marcin-chwedczuk/vga-experiments/schematics/vga-arduino.pdf

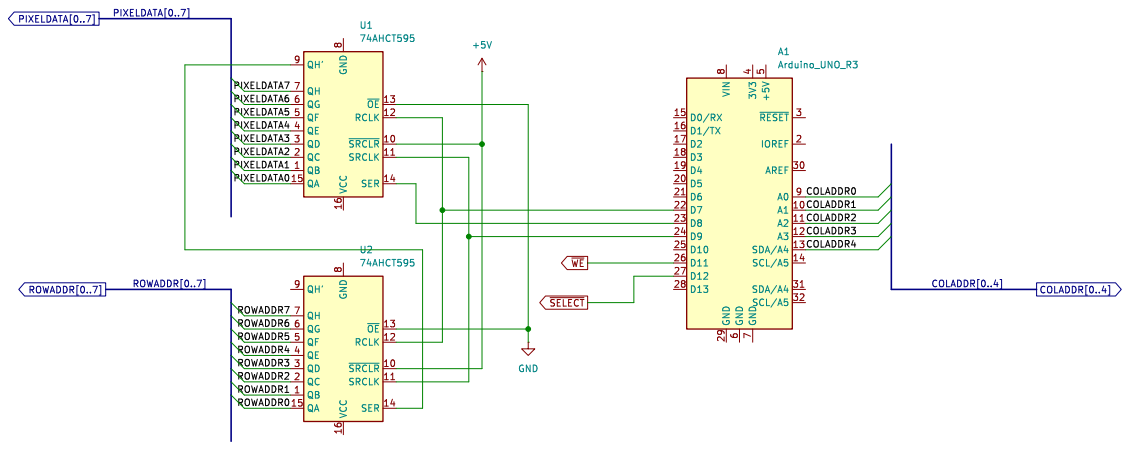
[picture p5: page 1]

8 A0 9 A1Arduino_UNO_R3 GND QB 1 ~{SRCLR} 10 SRCLK 11 RCLK 12 ~{OE} 13 SER 14 QA 15 VCC 16 QC 2 QD 3 QE 4 QF 5 QG 6 QH 7 GND

Id: 1/1 Title: File: vga-arduino.kicad_sch Sheet: /
