marcin-chwedczuk/vga-experiments/schematics/vga-memory.pdf

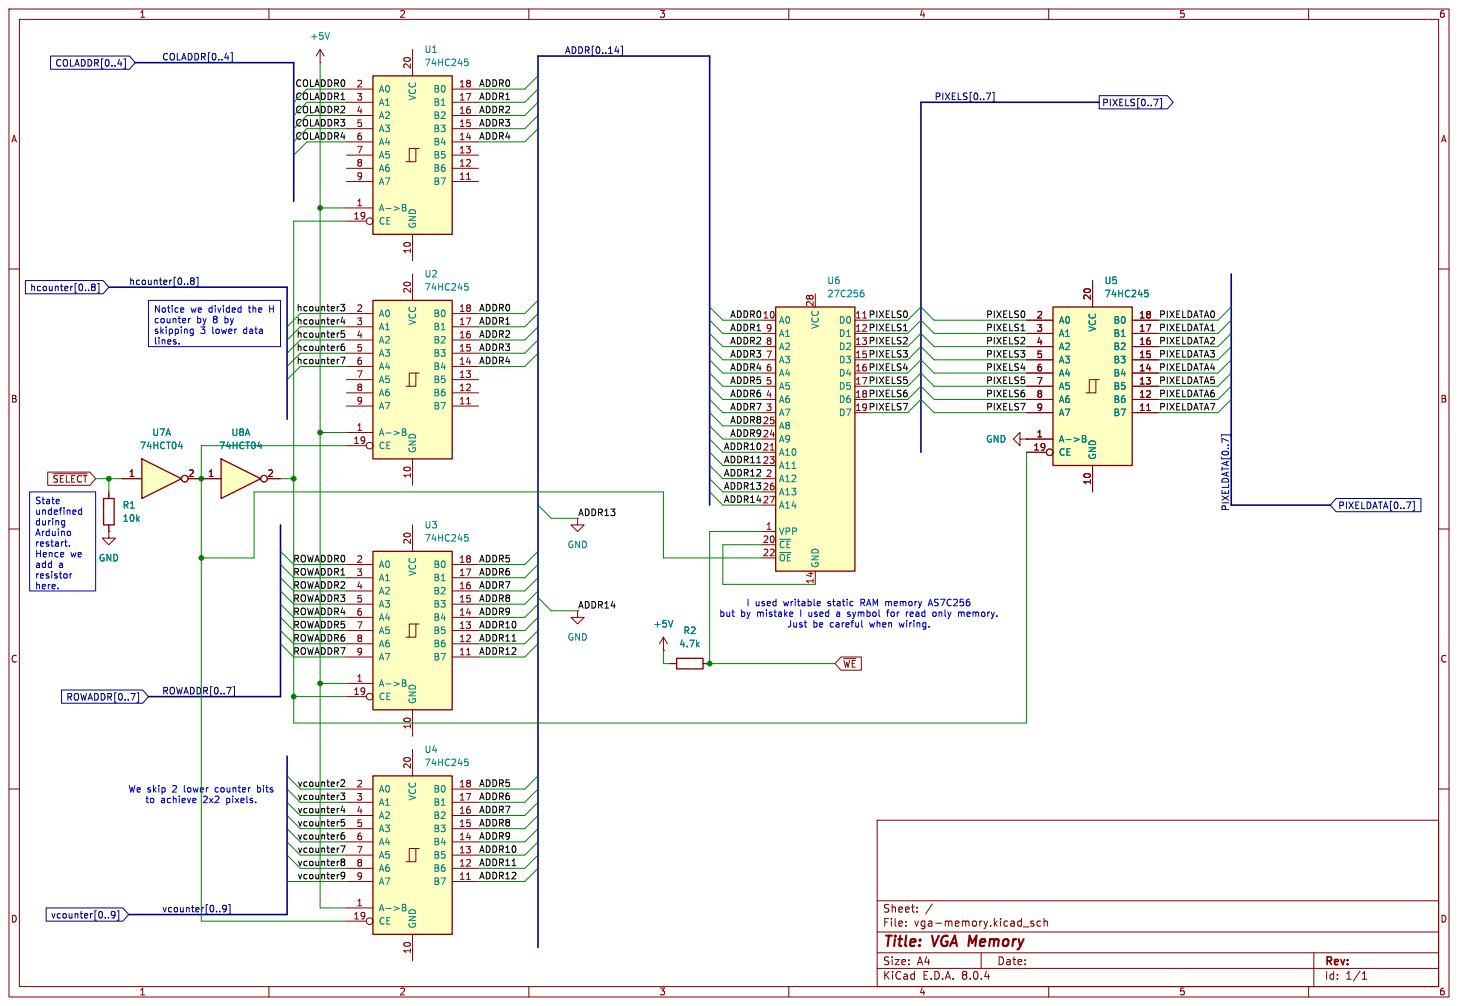
[picture p6: page 1]

Notice we divided the H
counter by 8 by

File: vga-memory.kicad_sch Sheet: /
Id: 1/1 Title: VGA Memory
