marcin-chwedczuk/vga-experiments/schematics/vga-timings.pdf

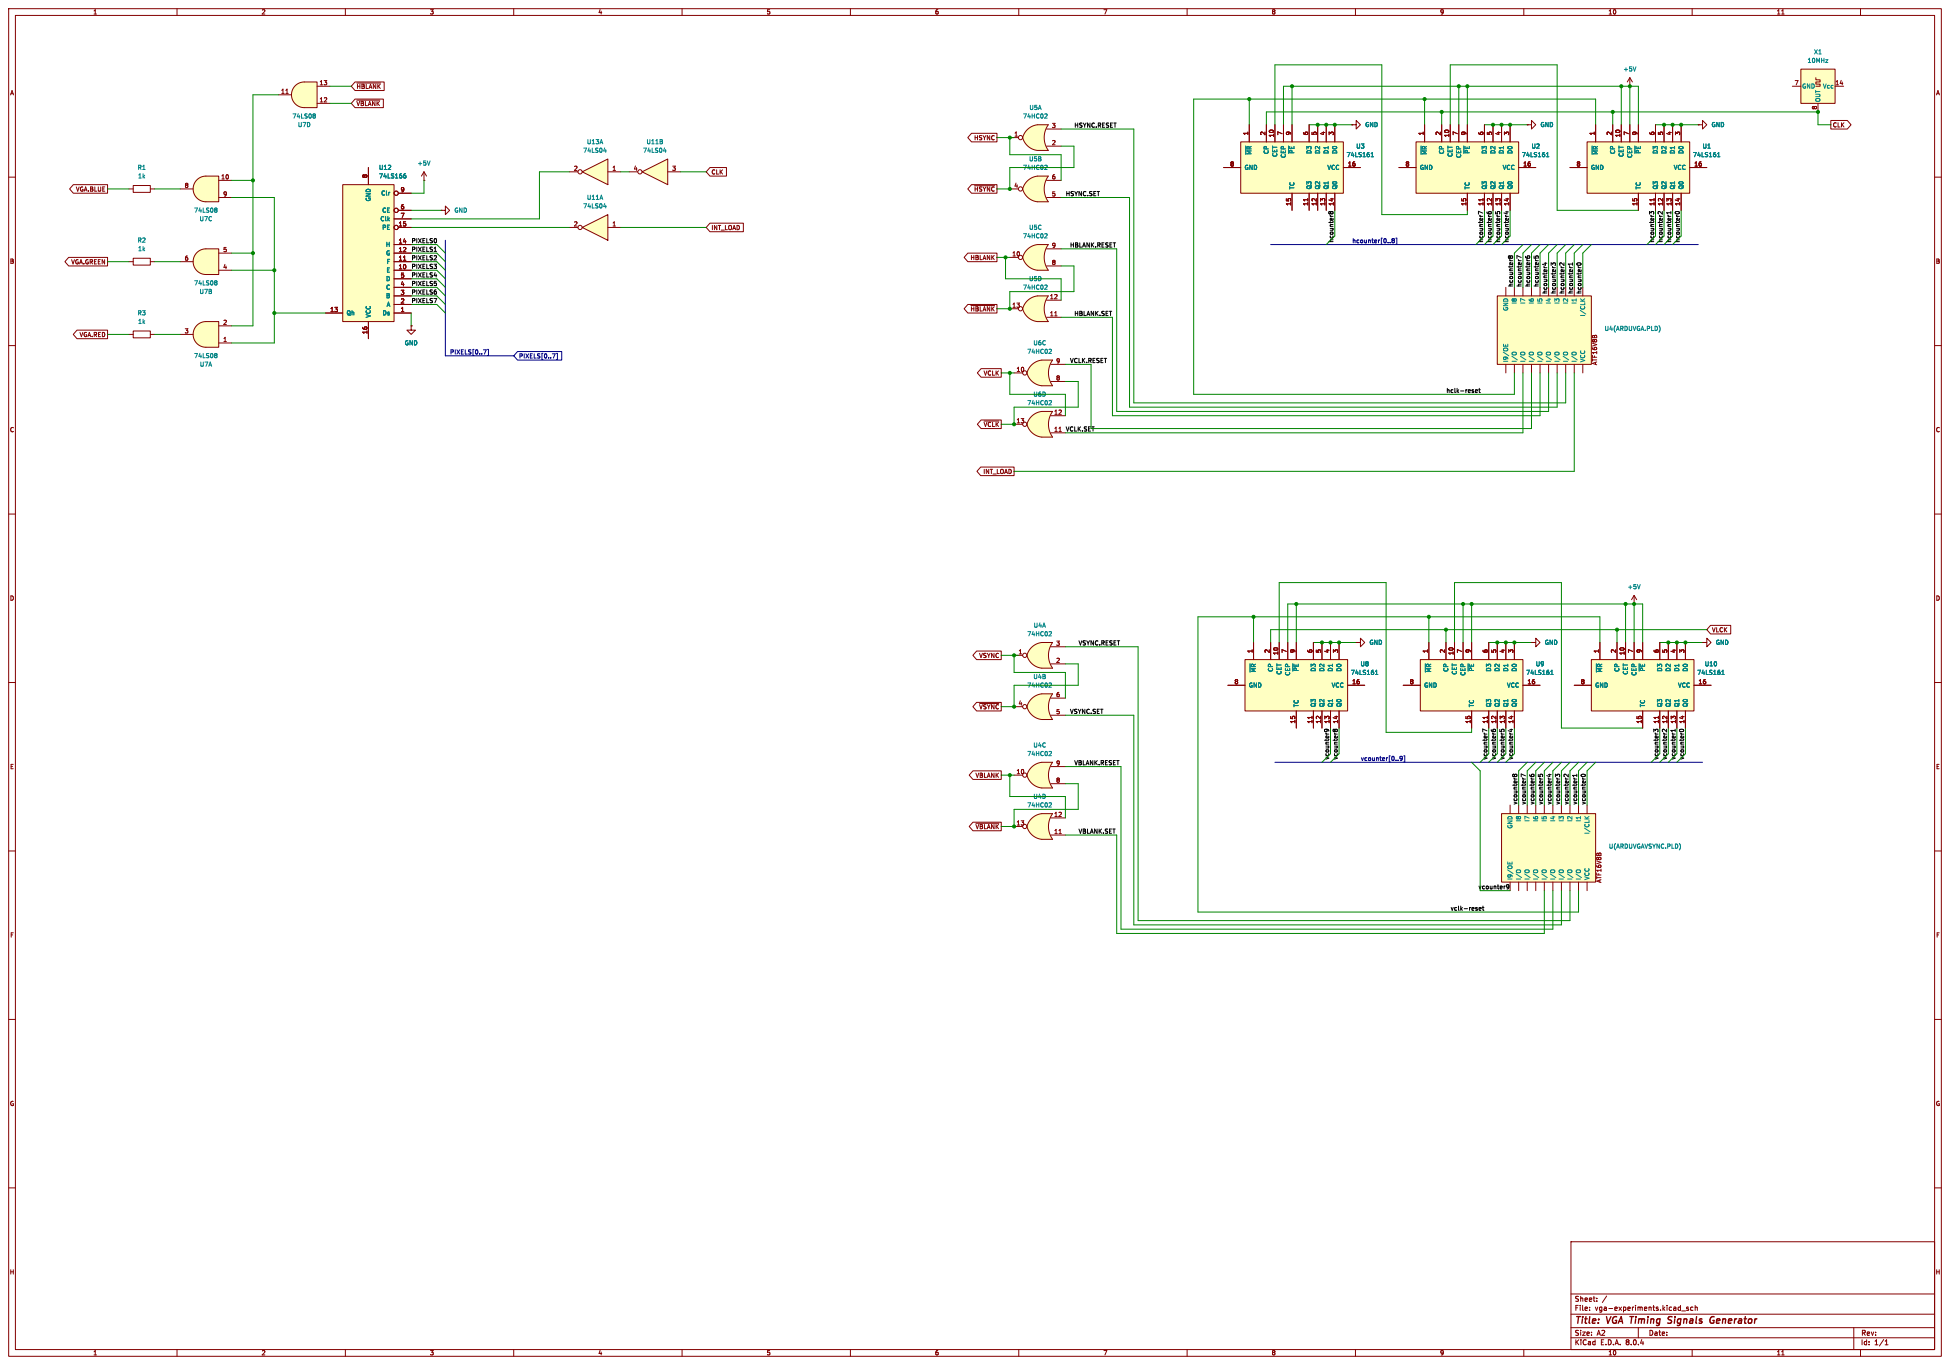
[picture p7: page 1]
