marcin-chwedczuk/vga-experiments/arduino-pictures-demo/vga-experiments-pictures.ino

// Images taken from: https://www.reddit.com/r/PixelArt/comments/jydset/another_compilation_of_1bit_pixel_art_pieces_took/

#define IMAGE_WIDTH (200)
#define IMAGE_HEIGHT (150)
static const uint8_t PROGMEM image_balloon[] = {
    0b11111110, 0b00000000, 0b00000000, 0b00000000, 0b00000000, 0b00000000, 0b00000000, 0b00000000, 0b00000000, 0b00000000, 0b00000000, 0b00000000, 0b00000000, 0b00000000, 0b00000000, 0b00000000, 0b00000000, 0b00000000, 0b00000000, 0b00000000, 0b00000000, 0b00000000, 0b00000000, 0b00000000, 0b00011111,
    0b11111100, 0b00000000, 0b00000000, 0b00000000, 0b00000000, 0b00000000, 0b00000000, 0b00000000, 0b00000000, 0b00000000, 0b00000000, 0b00000000, 0b00000000, 0b00000000, 0b00000000, 0b00000000, 0b00000000, 0b00000000, 0b00000000, 0b00000000, 0b00000000, 0b00000000, 0b00000000, 0b00000000, 0b00011111,
    0b11111110, 0b00000000, 0b00000000, 0b00000000, 0b00000000, 0b00000000, 0b00000000, 0b00000000, 0b00000000, 0b00000000, 0b00000000, 0b00000000, 0b00000000, 0b00000000, 0b00000000, 0b00000000, 0b00000000, 0b00000000, 0b00000000, 0b00000000, 0b00000000, 0b00000000, 0b00000000, 0b00000000, 0b00011111,
    0b11111100, 0b00000000, 0b00000000, 0b00000000, 0b00000000, 0b00000000, 0b00000000, 0b00000000, 0b00000000, 0b00000000, 0b00000000, 0b00010000, 0b00000001, 0b00010000, 0b00000000, 0b00000000, 0b00000000, 0b00000000, 0b00000000, 0b00000000, 0b00000000, 0b00000000, 0b00000000, 0b00000000, 0b00011111,
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
    0b00000000, 0b00000000, 0b00000000, 0b00000000, 0b00000000, 0b00000000, 0b00000110, 0b00000000, 0b01111001, 0b00100100, 0b10001001, 0b00100100, 0b10010010, 0b01000101, 0b01000101, 0b00000001, 0b11101111, 0b01111111, 0b11111110, 0b00000000, 0b00000000, 0b00000000, 0b00000000, 0b00000000, 0b01100110,
    0b00000000, 0b00000000, 0b00000000, 0b00000000, 0b00000000, 0b00000000, 0b00000110, 0b00000000, 0b01111000, 0b00000000, 0b00000000, 0b00000000, 0b00000000, 0b00000000, 0b00000000, 0b00000001, 0b11111111, 0b11111111, 0b10111110, 0b00000000, 0b00000000, 0b00000000, 0b00000000, 0b00000000, 0b01100110,
    0b00010000, 0b00000000, 0b00000000, 0b00000000, 0b00000000, 0b00000000, 0b00001010, 0b00000010, 0b10001001, 0b01010101, 0b01010101, 0b01010101, 0b01010101, 0b01011010, 0b10110101, 0b01110001, 0b00011101, 0b11111101, 0b11110010, 0b00000000, 0b00000000, 0b00000000, 0b00000000, 0b00000000, 0b10100110,
    0b00011000, 0b00000000, 0b00000000, 0b00000000, 0b00000000, 0b00000000, 0b00011000, 0b00000111, 0b10000001, 0b11111111, 0b11111111, 0b11111111, 0b11111111, 0b11111111, 0b11111111, 0b11111000, 0b00011111, 0b11110111, 0b11111000, 0b00000000, 0b00000000, 0b00000000, 0b00000000, 0b00000001, 0b10000110,
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
};

#define PIN_VGA_MODE_SELECTOR 12
#define VGA_MODE_READ LOW
#define VGA_MODE_WRITE HIGH

#define PIN_MEM_WRITE 11

#define PIN_SHIFT_REG_LATCH 7
#define PIN_SHIFT_REG_DATA 8
#define PIN_SHIFT_REG_CLK 9

void setColumnAddr(uint8_t addr) {
  // Column address A0 - A4
  int apins[] = { A0, A1, A2, A3, A4 };
  for (int i = 0; i < sizeof(apins) / sizeof(apins[0]); i++) {
    digitalWrite(apins[i], (addr & 1) ? HIGH : LOW);
    addr >>= 1;
  }
}

void setRowAddrAndData(uint8_t rowAddr, uint8_t data) {
  digitalWrite(PIN_SHIFT_REG_LATCH, LOW);

  shiftOut(PIN_SHIFT_REG_DATA, PIN_SHIFT_REG_CLK, MSBFIRST, rowAddr);
  shiftOut(PIN_SHIFT_REG_DATA, PIN_SHIFT_REG_CLK, MSBFIRST, data);

  digitalWrite(PIN_SHIFT_REG_LATCH, HIGH);
}

void setup() {
  pinMode(PIN_MEM_WRITE, OUTPUT);  
  digitalWrite(PIN_MEM_WRITE, HIGH);

  pinMode(PIN_VGA_MODE_SELECTOR, OUTPUT);
  digitalWrite(PIN_VGA_MODE_SELECTOR, VGA_MODE_READ);

  pinMode(PIN_SHIFT_REG_LATCH, OUTPUT);
  pinMode(PIN_SHIFT_REG_DATA, OUTPUT);
  pinMode(PIN_SHIFT_REG_CLK, OUTPUT);

  // Column address A0 - A4
  int apins[] = { A0, A1, A2, A3, A4 };
  for (int i = 0; i < sizeof(apins) / sizeof(apins[0]); i++) {
    pinMode(apins[i], OUTPUT);
    digitalWrite(apins[i], LOW);
  }
}

void write(int row, int col, uint8_t data) {
  setColumnAddr(col);
  setRowAddrAndData((uint8_t)row, data);

  digitalWrite(PIN_VGA_MODE_SELECTOR, VGA_MODE_WRITE);
  delay(0);
  // Generate write pulse

  digitalWrite(PIN_MEM_WRITE, LOW);
  delay(0);
  digitalWrite(PIN_MEM_WRITE, HIGH);

  delay(0);
  digitalWrite(PIN_VGA_MODE_SELECTOR, VGA_MODE_READ);
}

void displayImage(const uint8_t img[]) {
  for (int row = 0; row < 200; row++) {
    for (int col = 0; col < 25; col++) {
      uint8_t data = pgm_read_byte_near(&img[row*25 + col]);
      write(row, col, data);
    }
  }
}

void loop() {
  displayImage(image_balloon);
  delay(5000);
  displayImage(image_sphere);
  delay(5000);
  displayImage(image_wizard);
  delay(5000);
}
